fossi-foundation/sky130_pa_ip__instramp/docs/sky130_pa_ip__instramp_schematic.md

# CACE Summary for sky130_pa_ip__instramp

**netlist source**: schematic

| Parameter | Tool | Result | Min Limit  |  Min Value | Typ Target |  Typ Value | Max Limit  |  Max Value |  Status  |
| :--- | :--- | :--- | ---: | ---: | ---: | ---: | ---: | ---: | :---: |
| Idd | ngspice | result | any | 0.102 µA | 170 µA |  46.588 µA | 250 µA |  67.982 µA | Pass ✅ |
| Area | magic_area | area | | | | | any | | Skip 🟧 |
| Width | magic_area | width | | | | | any | | Skip 🟧 |
| Height | magic_area | height | | | | | any | | Skip 🟧 |
| Magic DRC | magic_drc | drc_errors | | | | | 0 | | Skip 🟧 |
| Netgen LVS | netgen_lvs | lvs_errors | | | | | 0 | | Skip 🟧 |
| KLayout DRC feol | klayout_drc | drc_errors | | | | | 0 | | Skip 🟧 |
| KLayout DRC beol | klayout_drc | drc_errors | | | | | 0 | | Skip 🟧 |
| KLayout DRC full | klayout_drc | drc_errors | | | | | 0 | | Skip 🟧 |
| Antenna Checks | magic_antenna_check  | antenna_violations | | | | | 0 | | Skip 🟧 |

## Plots
