fossi-foundation/sky130_pa_ip__instramp/(commit log)

2024-10-21 Initial commit of files from Phil Allen for the programmable gain amplifier. Modified the schematics to remove ideal components within the IP and replace them with sky130 components. Changed the digi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
    [5V_Inverter1.sch, Input_Stage_OA1.sch, Input_Stage_OA2.sch, Input_Stage_v1.sch, Output_OA.sch, Parallel_10B_Block2.sch, Parallel_PGA_Complete_DC.sch, T_Gate_5V.sch]
2024-11-04 Created initial layouts for floorplanning; started work on the output amp final layout. Schematics have been modified to change devices to save area, namely changing the poly resistors to xres at the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
    [Input_Stage_OA1.sch, Input_Stage_OA2.sch, Input_Stage_v1.sch, Output_OA.sch, Parallel_10B_Block2.sch, Parallel_PGA_Complete_DC.sch, Universal_R_2R_Block2.sch, sky130_pa_ip__instramp.sch]
2024-11-07 Updated with completed layout, DRC and LVS clean (except for a small property error that needs to be fixed).
    [Input_Stage_v1.sch, Parallel_10B_Block2.sch, T_Gate_5V.sch, Universal_R_2R_Block2.sch, vbias_gen_pga.sch]
2024-11-07 Made one additional layout change to resolve a small difference between the largest resistor value (7.3Mohms) in the schematic vs. layout (property error). Timestamps updated on many of the layout fi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
2024-11-07 Add CACE setup
    [dccurrent_vdd.sch]
2024-11-07 Add antenna check
2024-11-09 Updated the layout to center the digital level shifters relative to the rest of the layout, which gives room on both sides to extend out the analog power and ground buses and makes a better power gri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
2024-11-09 Modified the schematic, which was written assuming single-ended input, to separate the VINN input from VCM so that the block can be configured for a differential input. The negative input can be conn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
    [sky130_pa_ip__instramp.sch]
2024-11-16 Modified the instrumentation amplifier input stage layout to avoid implying a pwell around the perimeter where there is nwell in the top level. This appears to be an extraction issue in magic and nee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
2024-11-20 Short ammeter in LVS netlist
    [Input_Stage_OA1.sch, Input_Stage_OA2.sch, Input_Stage_v1.sch, Output_OA.sch, Parallel_10B_Block2.sch, Parallel_PGA_Complete_DC.sch, T_Gate_5V.sch, Universal_R_2R_Block2.sch]
2024-12-02 Fix syntax error in schematic
    The line ends with double braces, which does not seem to be an issue for xschem, but it is for xschem-viewer.
    [sky130_pa_ip__instramp.sch]
